TKWTL/3S1P-21700-Power-Bank/调试/空载（带表）纹波.jpg

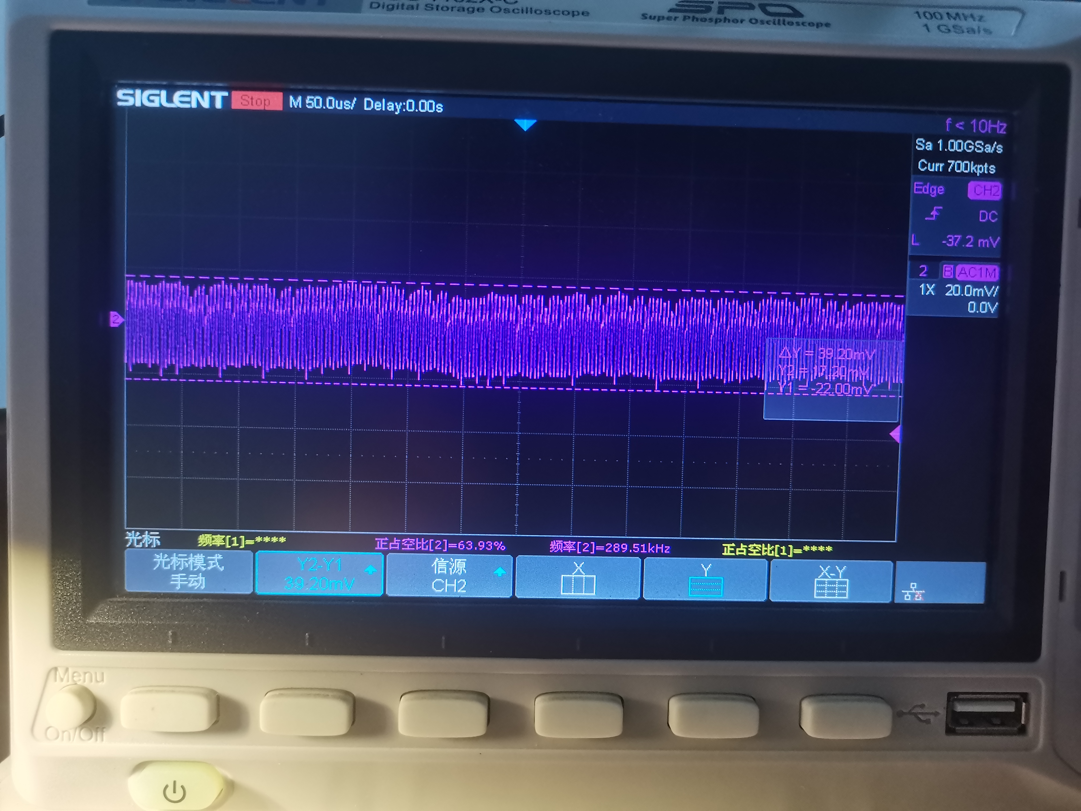
调试/空载（带表）纹波.jpg
