TKWTL/3S1P-21700-Power-Bank/硬件/下半部分组装.jpg

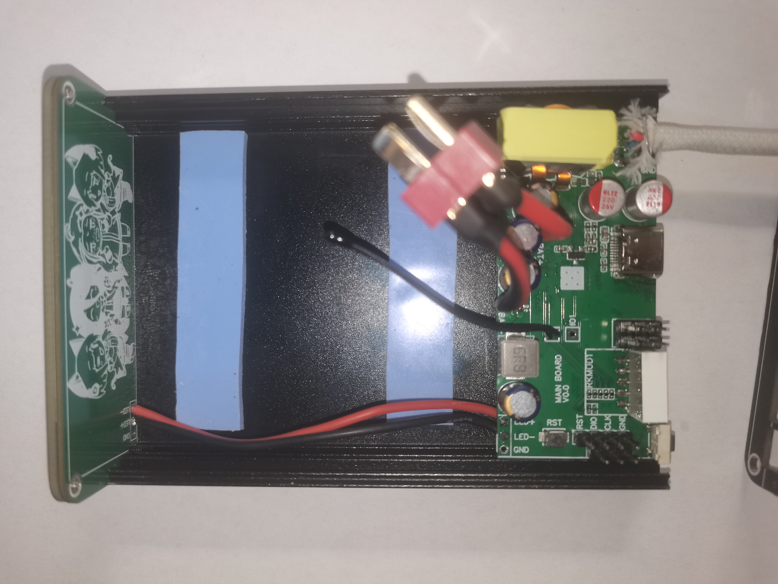
硬件/下半部分组装.jpg
