TKWTL/3S1P-21700-Power-Bank/硬件/3块主板焊接后.jpg

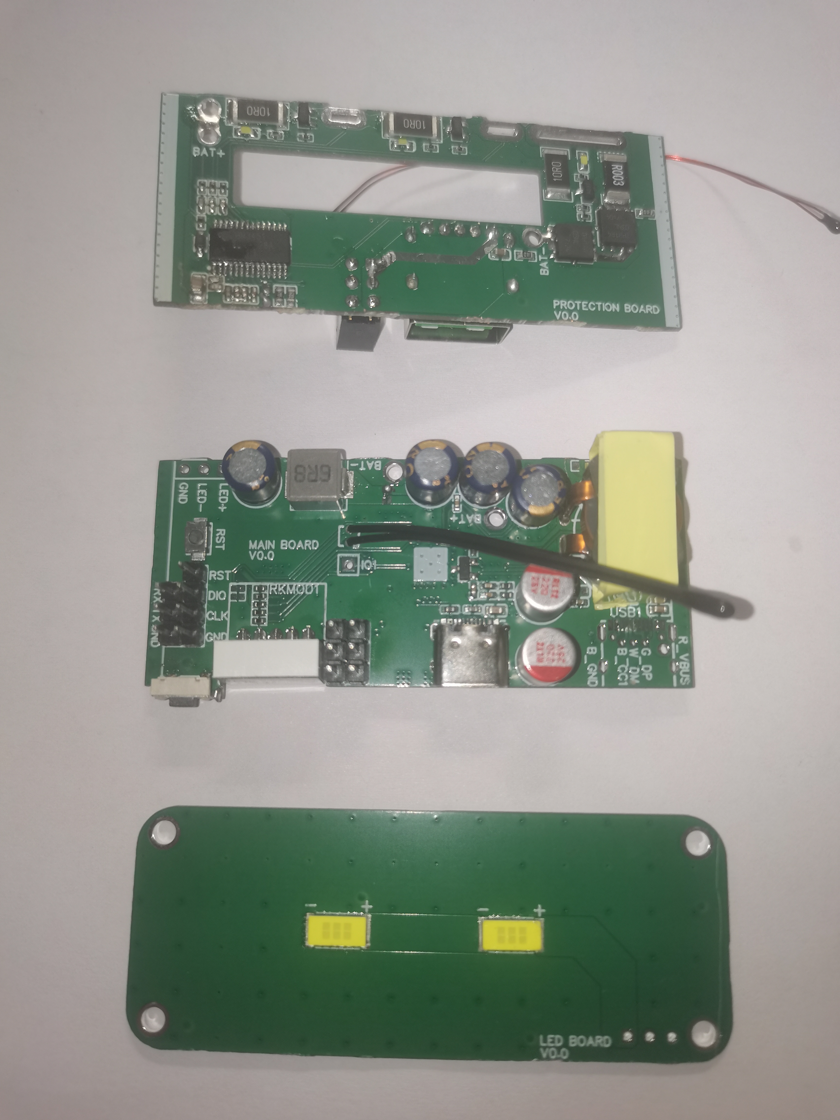
硬件/3块主板焊接后.jpg
