TKWTL/3S1P-21700-Power-Bank/硬件/PCB板一览.jpg

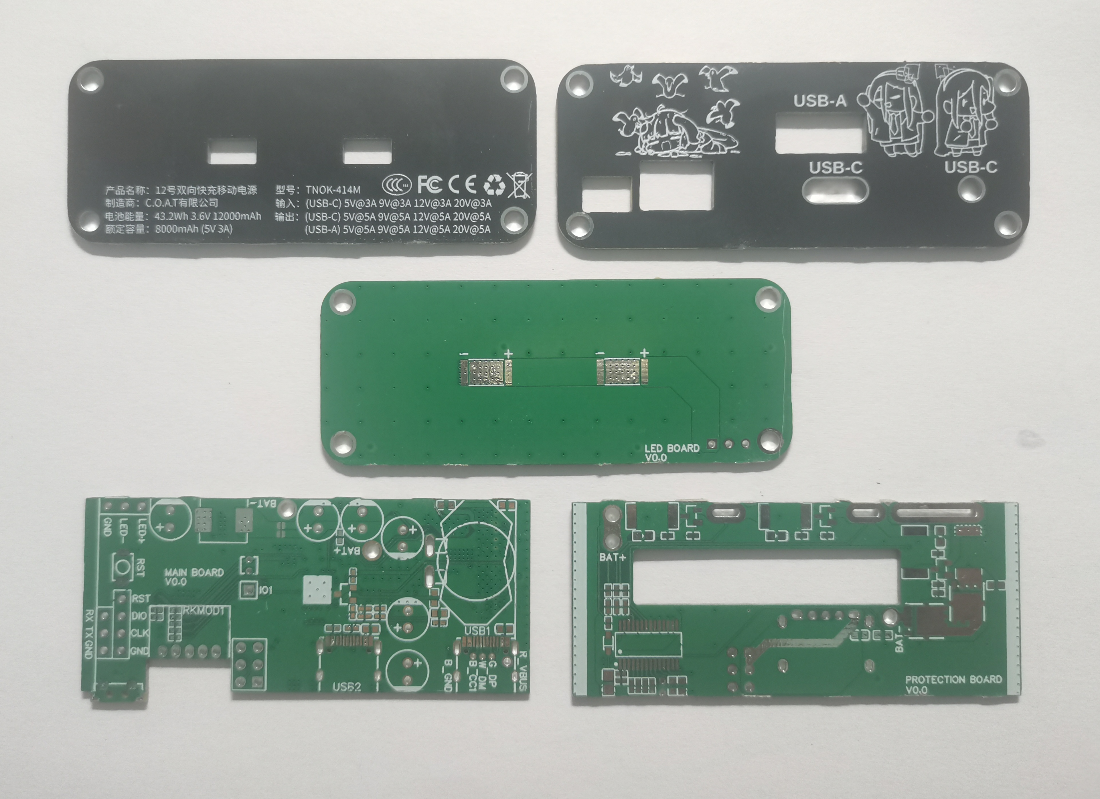
硬件/PCB板一览.jpg
