TKWTL/3S1P-21700-Power-Bank/硬件/使用的3070 LED灯珠背面.jpg

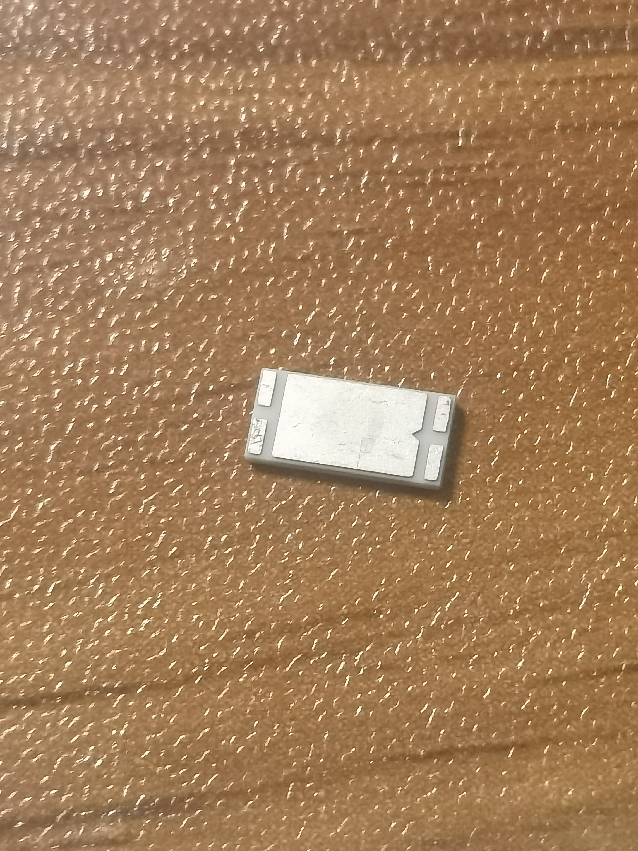
硬件/使用的3070 LED灯珠背面.jpg
