TKWTL/3S1P-21700-Power-Bank/硬件/使用的RM6扁铜线电感.jpg

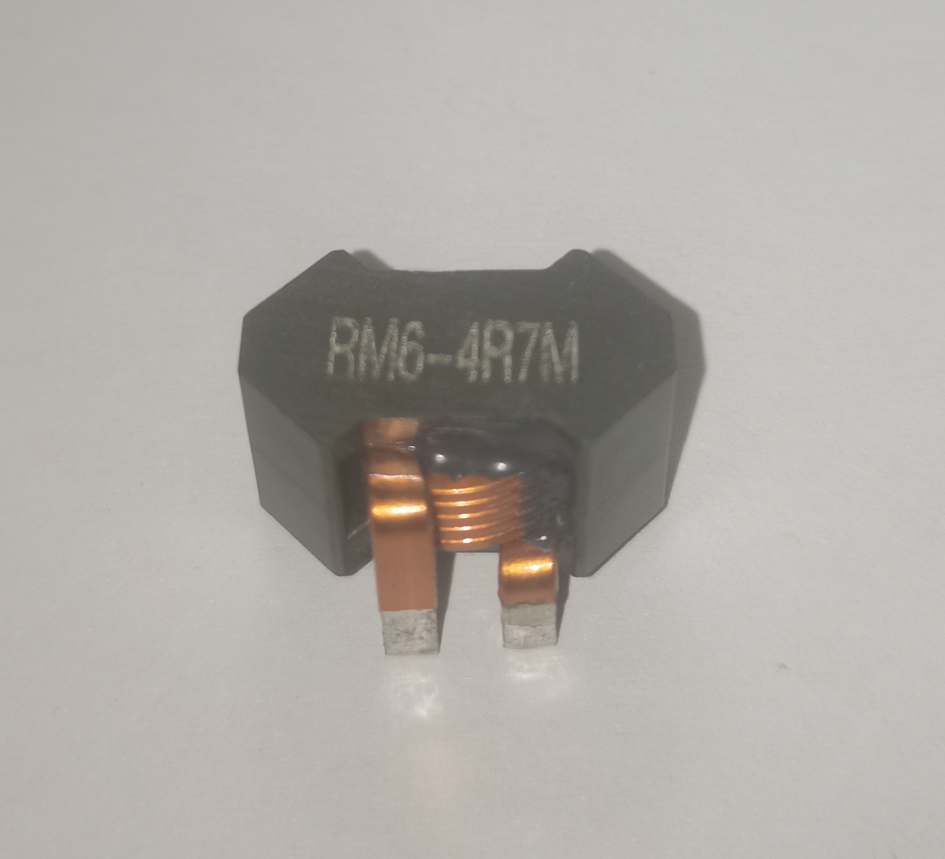
硬件/使用的RM6扁铜线电感.jpg
