TKWTL/3S1P-21700-Power-Bank/硬件/使用的电池组 #1.jpg

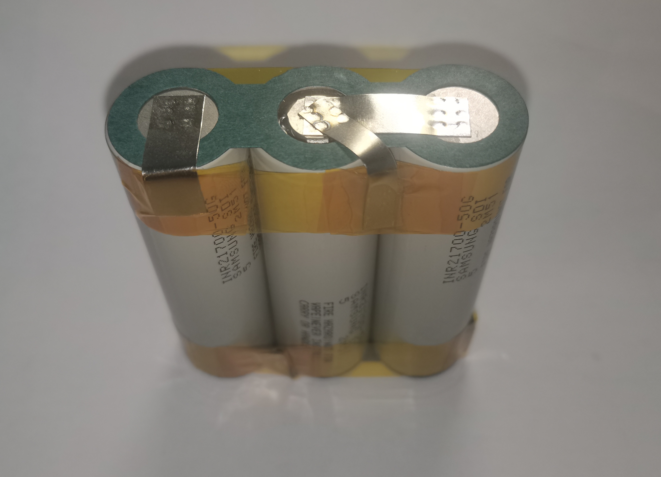
硬件/使用的电池组 #1.jpg
