TKWTL/3S1P-21700-Power-Bank/硬件/保护板连接电池.jpg

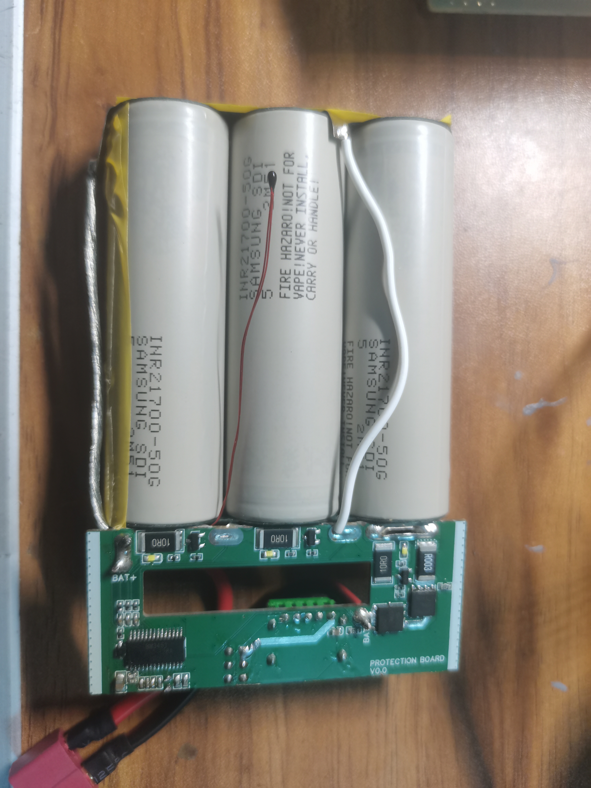
硬件/保护板连接电池.jpg
