TKWTL/3S1P-21700-Power-Bank/硬件/外壳2mm导热垫贴放位置.jpg

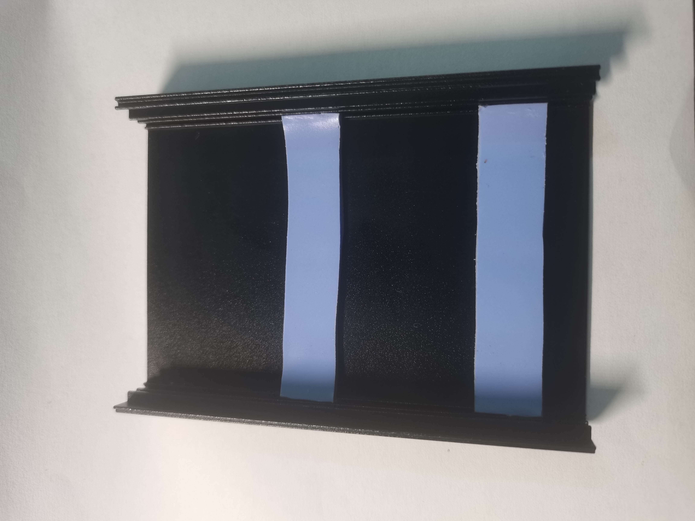
硬件/外壳2mm导热垫贴放位置.jpg
