TKWTL/3S1P-21700-Power-Bank/硬件/外壳机械尺寸图.png

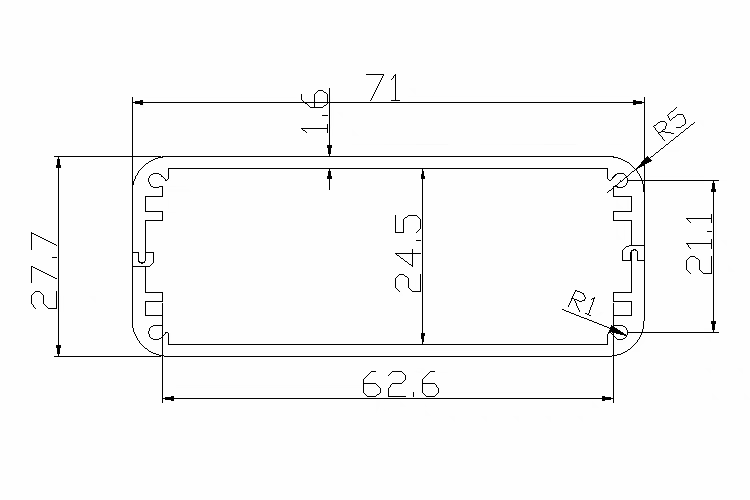
硬件/外壳机械尺寸图.png
