TKWTL/3S1P-21700-Power-Bank/硬件/成品图.jpg

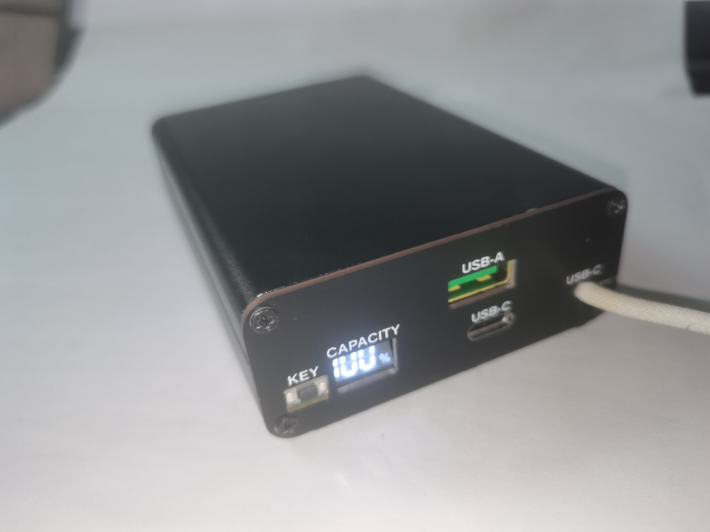
硬件/成品图.jpg
