TKWTL/3S1P-21700-Power-Bank/硬件/焊接好的主板背面.jpg

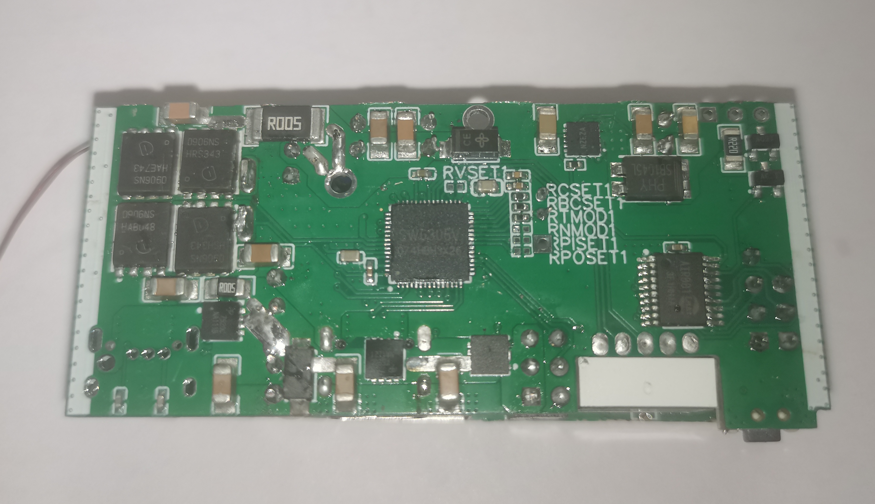
硬件/焊接好的主板背面.jpg
