TKWTL/3S1P-21700-Power-Bank/调试/80W纹波.jpg

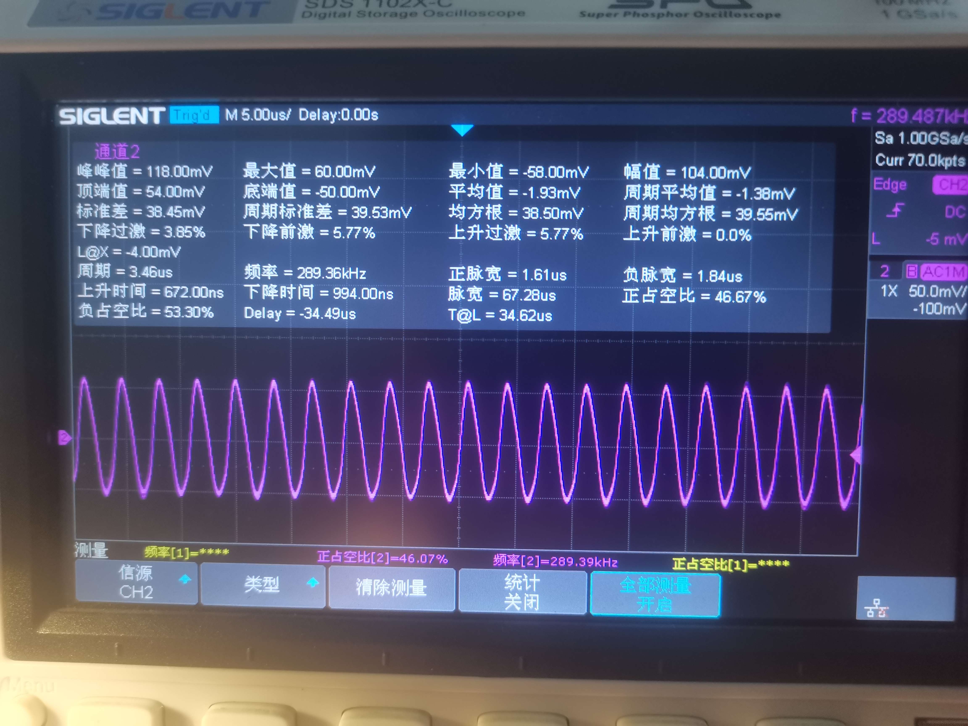
调试/80W纹波.jpg
