TKWTL/3S1P-21700-Power-Bank/调试/A口快充协议检测.jpg

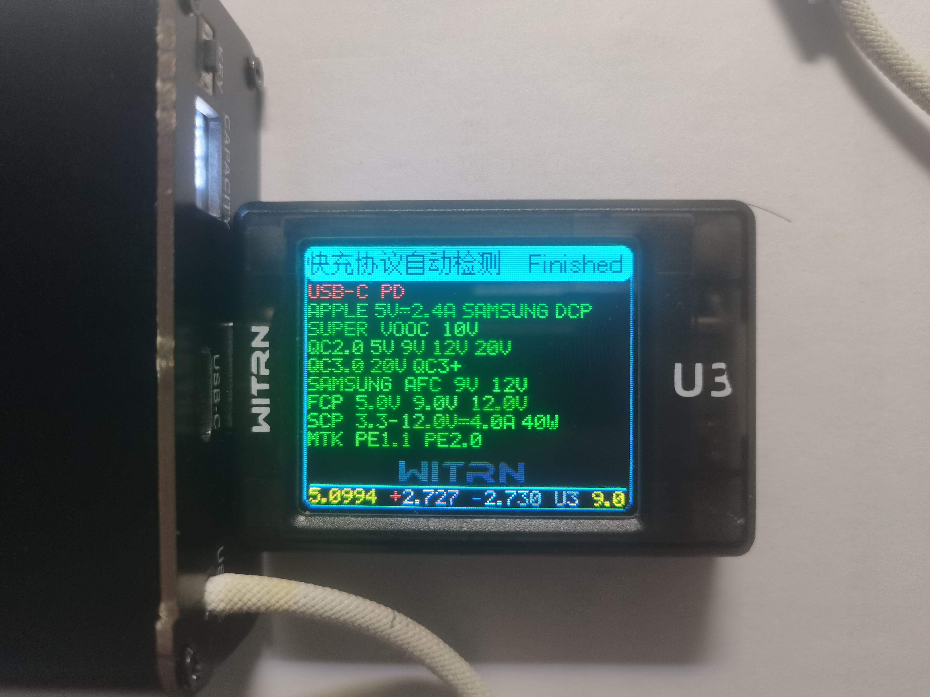
调试/A口快充协议检测.jpg
