TKWTL/3S1P-21700-Power-Bank/调试/C2口PDO.jpg

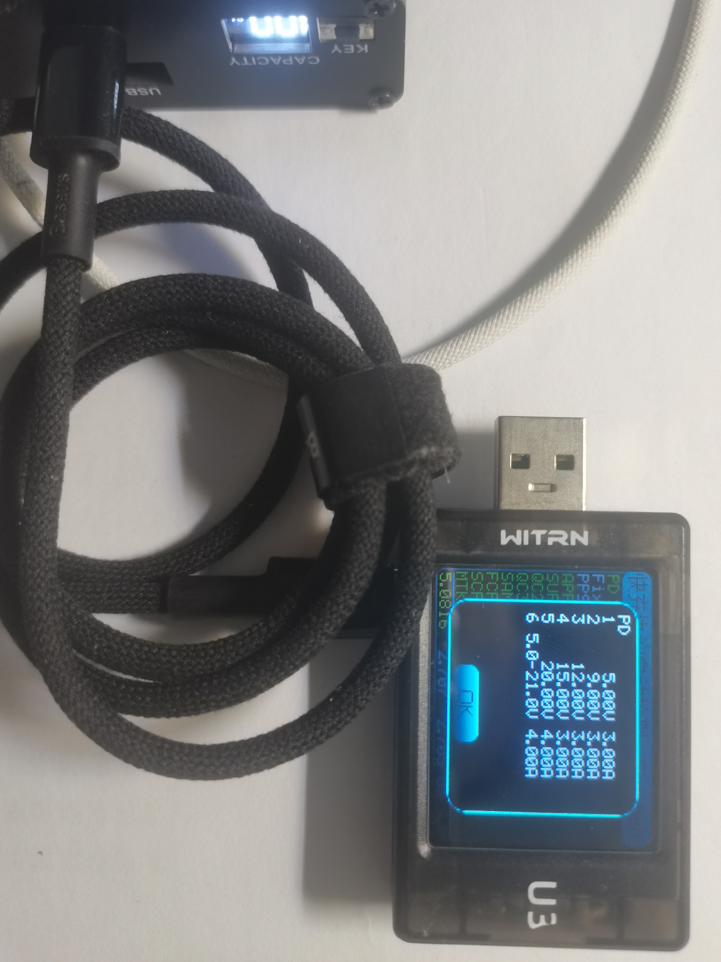
调试/C2口PDO.jpg
