TKWTL/3S1P-21700-Power-Bank/调试/PD诱骗20W输出.jpg

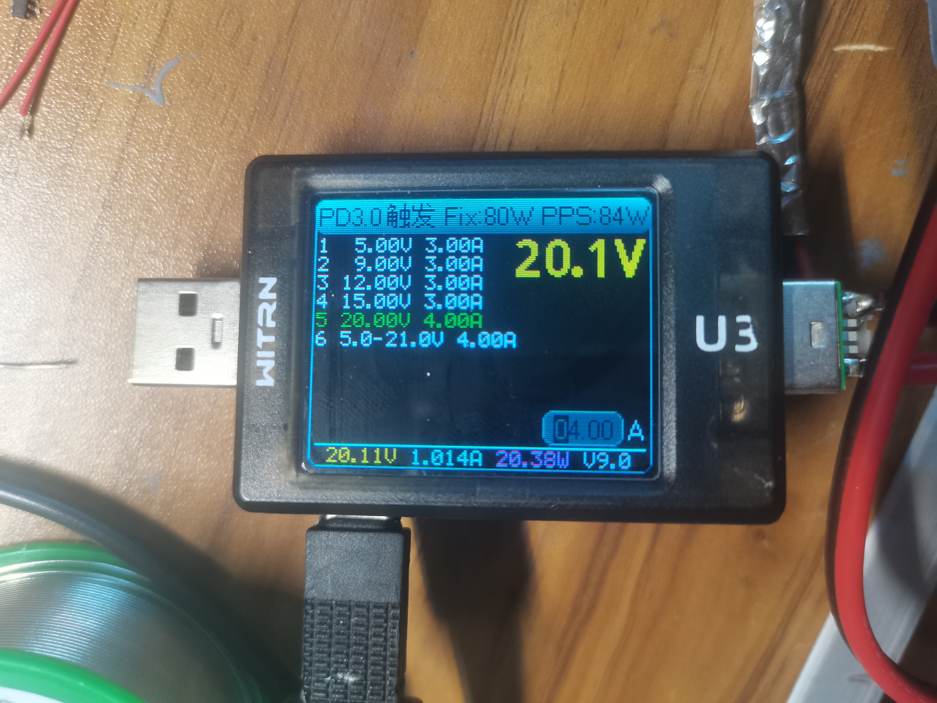
调试/PD诱骗20W输出.jpg
