TKWTL/3S1P-21700-Power-Bank/调试/UFCS协议.jpg

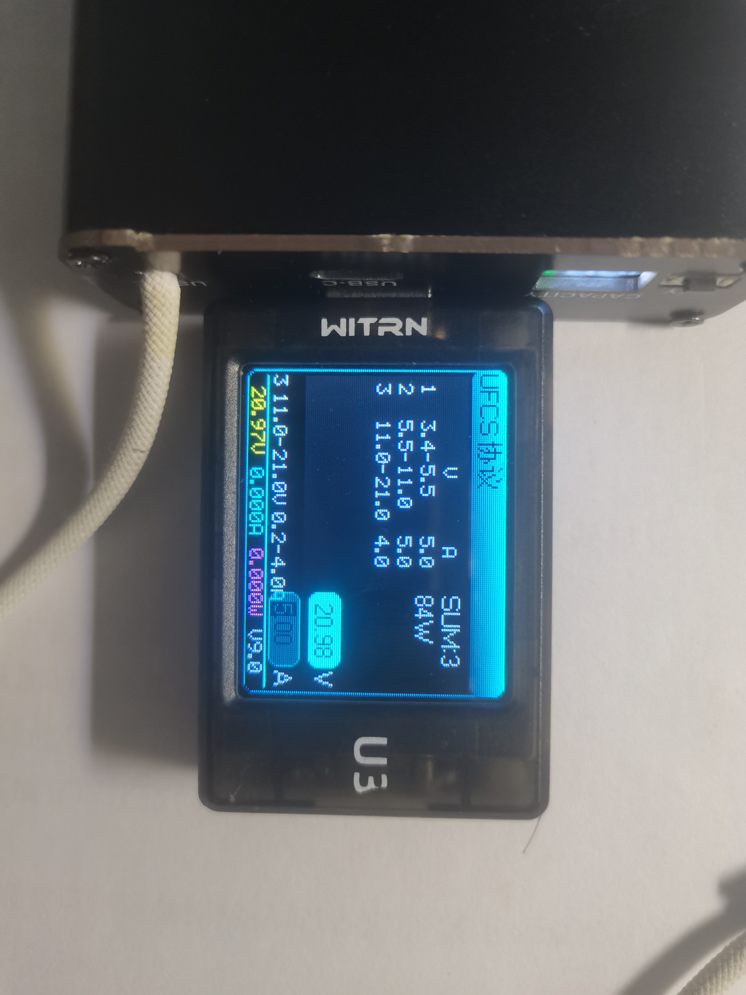
调试/UFCS协议.jpg
