TKWTL/3S1P-21700-Power-Bank/硬件/Schematic_3S1P-21700移动电源_2024-08-13.pdf

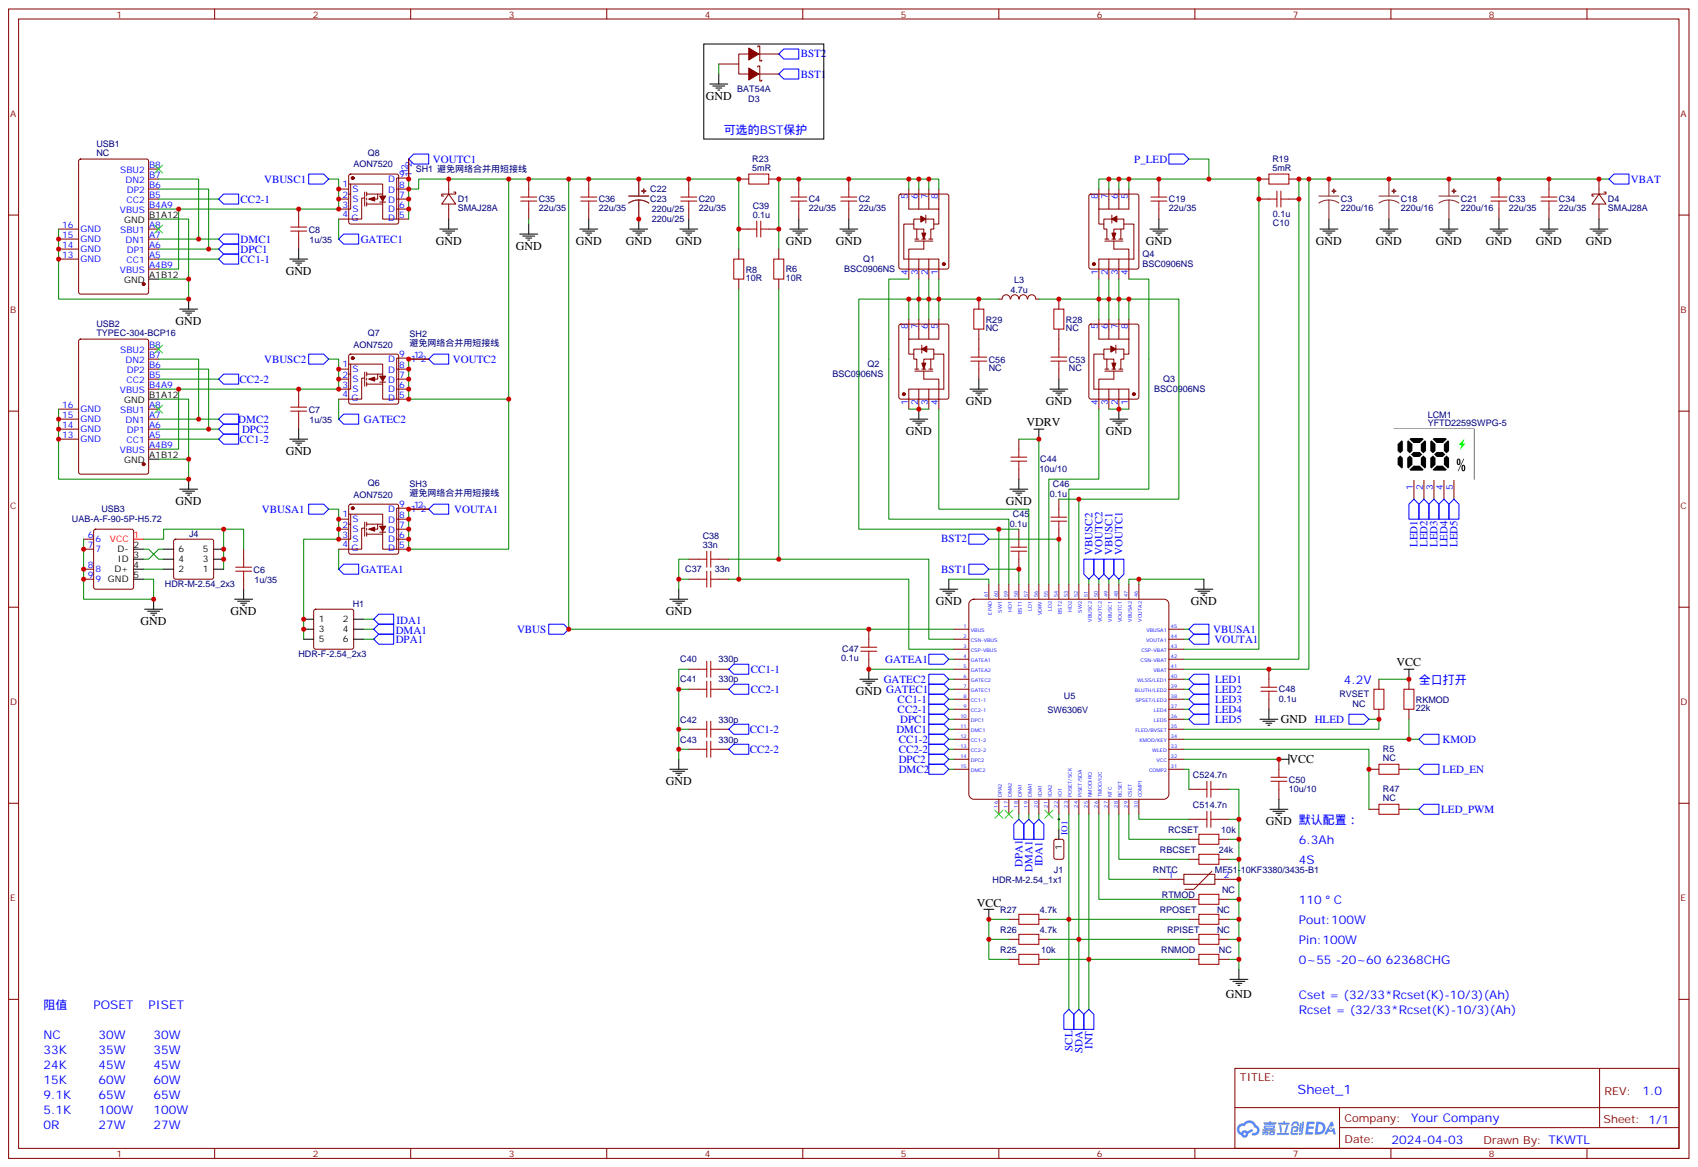
[picture p24: page 1]

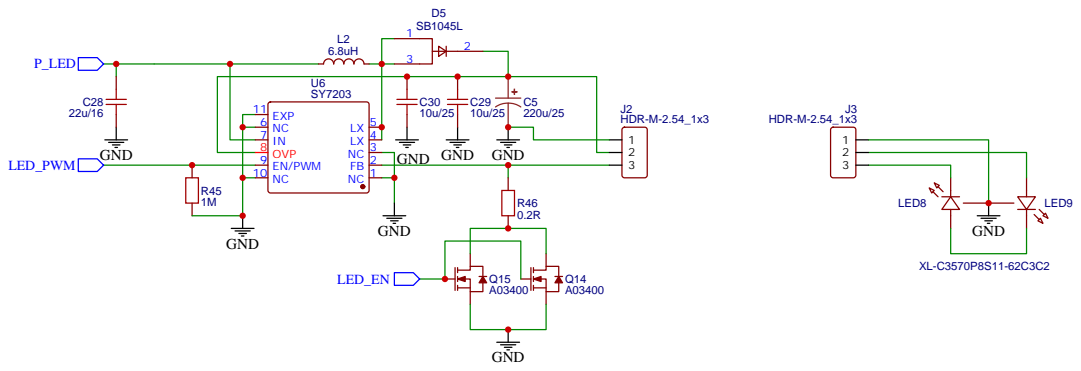
[picture p25: page 2]

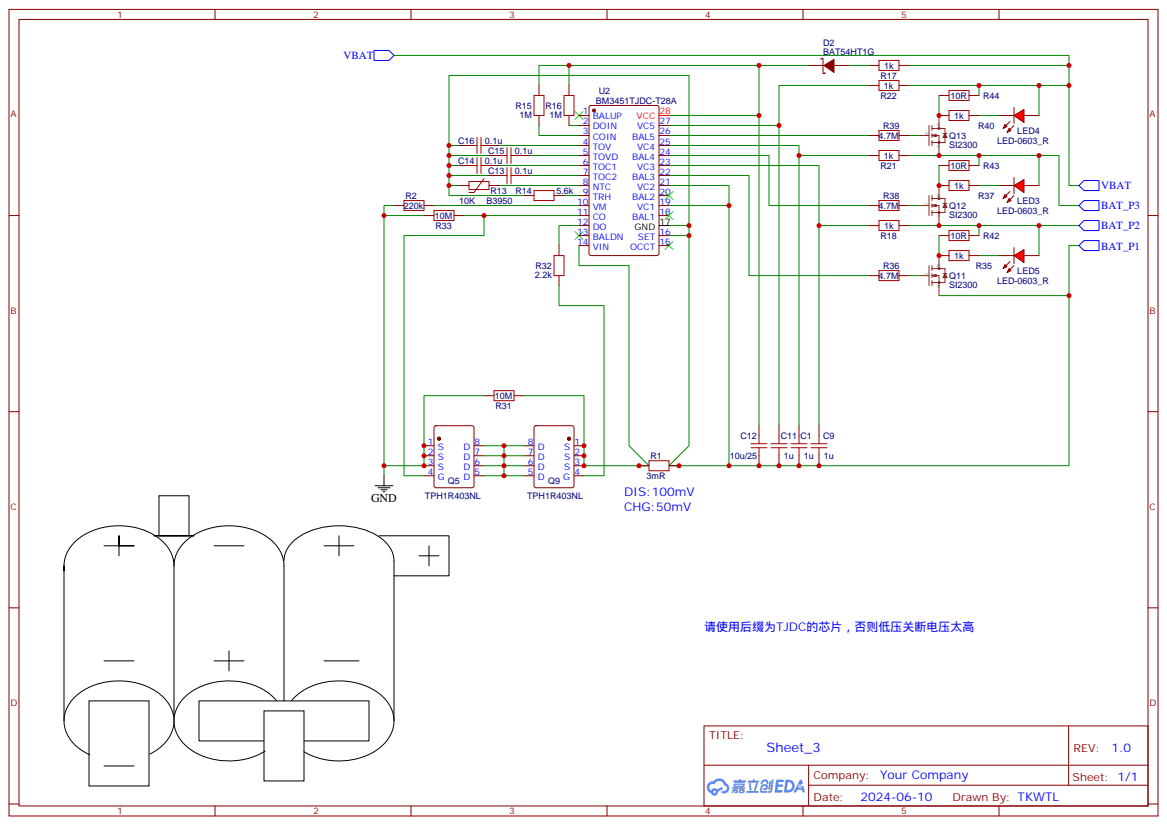
[picture p26: page 3]

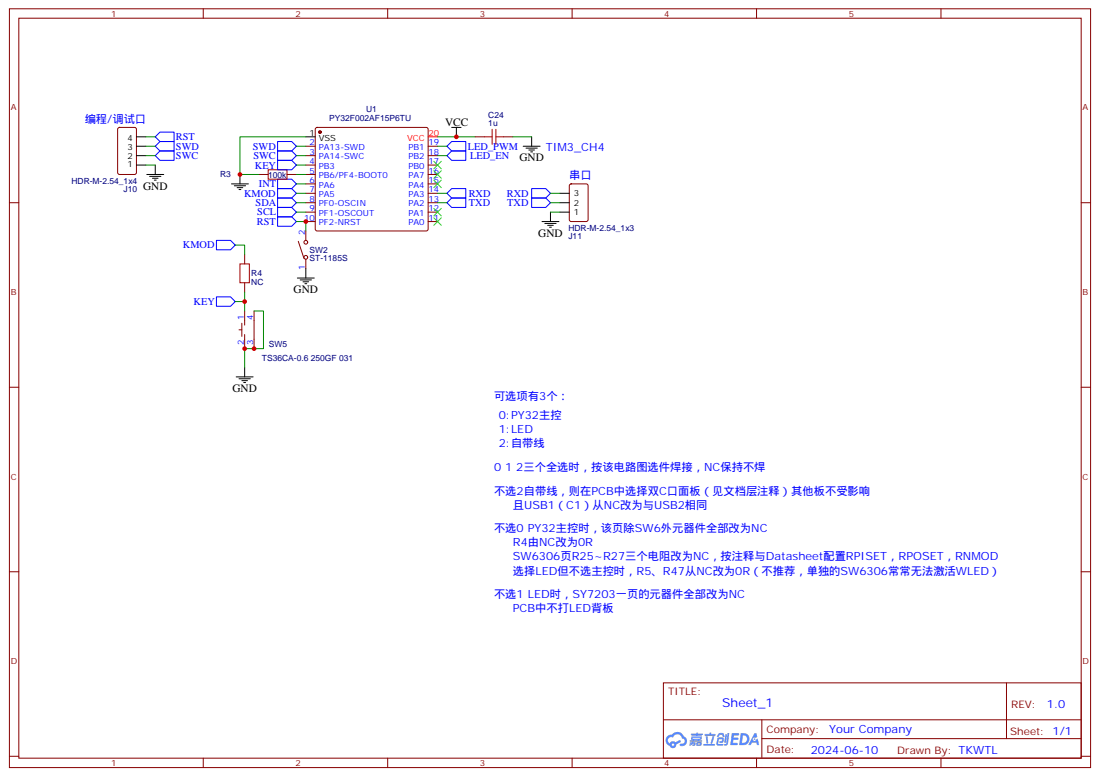
[picture p27: page 4]
