TKWTL/3S1P-21700-Power-Bank/软件/main.h

/* Define to prevent recursive inclusion -------------------------------------*/
#ifndef __MAIN_H
#define __MAIN_H

#ifdef __cplusplus
extern "C" {
#endif


#if defined(USE_FULL_ASSERT)
#include "py32_assert.h"
#endif /* USE_FULL_ASSERT */

/* Private includes ----------------------------------------------------------*/
#include "defines.h"
#include "coroOS.h"
#include "bsp_py32f030x6.h"
/* Private defines -----------------------------------------------------------*/
/* Exported variables prototypes ---------------------------------------------*/
/* Exported functions prototypes ---------------------------------------------*/
void APP_ErrorHandler(void);

#ifdef __cplusplus
}
#endif

#endif /* __MAIN_H */
