TKWTL/3S1P-21700-Power-Bank/软件/Drivers/Inc/py32f0xx_bsp_pwr.h

#ifndef __PY32F0XX_BSP_PWR_H__
#define __PY32F0XX_BSP_PWR_H__

#ifdef __cplusplus
extern "C" {
#endif

#include "defines.h"
#include "coroOS.h"
    
void BSP_PWR_Config();
    
#ifdef __cplusplus
}
#endif

#endif /* PY32F003_BSP_CLOCK_H */
