TKWTL/3S1P-21700-Power-Bank/软件/Drivers/Src/py32f0xx_bsp_gpio.c

#include "py32f0xx_bsp_gpio.h"

void BSP_GPIO_Config()
{   
    LL_GPIO_InitTypeDef GPIO_InitStruct = {0};

    LL_IOP_GRP1_EnableClock(LL_IOP_GRP1_PERIPH_GPIOA | LL_IOP_GRP1_PERIPH_GPIOB | LL_IOP_GRP1_PERIPH_GPIOF);
        
    //PF4配置为模拟输入
    GPIO_InitStruct.Pin = LL_GPIO_PIN_4;
    GPIO_InitStruct.Mode = LL_GPIO_MODE_ANALOG ;
    GPIO_InitStruct.Speed = LL_GPIO_SPEED_FREQ_HIGH;
    GPIO_InitStruct.OutputType = LL_GPIO_OUTPUT_PUSHPULL;
    GPIO_InitStruct.Pull = LL_GPIO_PULL_DOWN;
    GPIO_InitStruct.Alternate = LL_GPIO_AF_0;
    LL_GPIO_Init(GPIOF, &GPIO_InitStruct);
    
    //用户配置口线
    //输入区
    GPIO_InitStruct.Pin = INT_PIN;
    GPIO_InitStruct.Mode = LL_GPIO_MODE_INPUT;
    GPIO_InitStruct.Speed = LL_GPIO_SPEED_FREQ_HIGH;
    GPIO_InitStruct.OutputType = LL_GPIO_OUTPUT_PUSHPULL;
    GPIO_InitStruct.Pull = LL_GPIO_PULL_UP;
    GPIO_InitStruct.Alternate = LL_GPIO_AF_0;
    LL_GPIO_Init(INT_PORT, &GPIO_InitStruct);
    
    GPIO_InitStruct.Pin = KEY_PIN;
    GPIO_InitStruct.Mode = LL_GPIO_MODE_INPUT;
    GPIO_InitStruct.Speed = LL_GPIO_SPEED_FREQ_HIGH;
    GPIO_InitStruct.OutputType = LL_GPIO_OUTPUT_PUSHPULL;
    GPIO_InitStruct.Pull = LL_GPIO_PULL_UP;
    GPIO_InitStruct.Alternate = LL_GPIO_AF_0;
    LL_GPIO_Init(KEY_PORT, &GPIO_InitStruct);
    
    //输出区
    LED_INITSTA(LED_PORT,LED_PIN);
    GPIO_InitStruct.Pin = LED_PIN;
    GPIO_InitStruct.Mode = LL_GPIO_MODE_OUTPUT;
    GPIO_InitStruct.Speed = LL_GPIO_SPEED_FREQ_LOW;
    GPIO_InitStruct.OutputType = LL_GPIO_OUTPUT_PUSHPULL;
    GPIO_InitStruct.Pull = LL_GPIO_PULL_NO;
    GPIO_InitStruct.Alternate = LL_GPIO_AF_0;
    LL_GPIO_Init(LED_PORT, &GPIO_InitStruct);
    
}
