TKWTL/3S1P-21700-Power-Bank/软件/Drivers/Inc/py32f0xx_bsp_adc.h

#ifndef __PY32F0XX_BSP_ADC_H__
#define __PY32F0XX_BSP_ADC_H__

#ifdef __cplusplus
extern "C" {
#endif

#include "defines.h"
#include "coroOS.h"

void BSP_ADC_Config();
    
#ifdef __cplusplus
}
#endif

#endif
