TKWTL/3S1P-21700-Power-Bank/软件/Drivers/Inc/py32f0xx_bsp_exti.h

#ifndef __PY32F003_BSP_EXTI_H__
#define __PY32F003_BSP_EXTI_H__

#ifdef __cplusplus
extern "C" {
#endif

#include "defines.h"
#include "coroOS.h"
    
void BSP_EXTI_Config();

#ifdef __cplusplus
}
#endif

#endif /* PY32F003_BSP_CLOCK_H */
