TKWTL/3S1P-21700-Power-Bank/软件/Drivers/Inc/py32f0xx_bsp_tim.h

#ifndef __PY32F0XX_BSP_TIM_H__
#define __PY32F0XX_BSP_TIM_H__

#ifdef __cplusplus
extern "C" {
#endif

#include "defines.h"
#include "coroOS.h"

void BSP_TIM_config(void);
void BSP_PWMChannelConfig(void);
    
void LED_PWM_Set(uint8_t indensity);
    
#ifdef __cplusplus
}
#endif

#endif
