TKWTL/3S1P-21700-Power-Bank/(commit log)

2026-04-12 修复偶发卡死
2026-08-08 状态卡住bug修复
